bizon76/esr-meter/design/schematic-v1.1.pdf

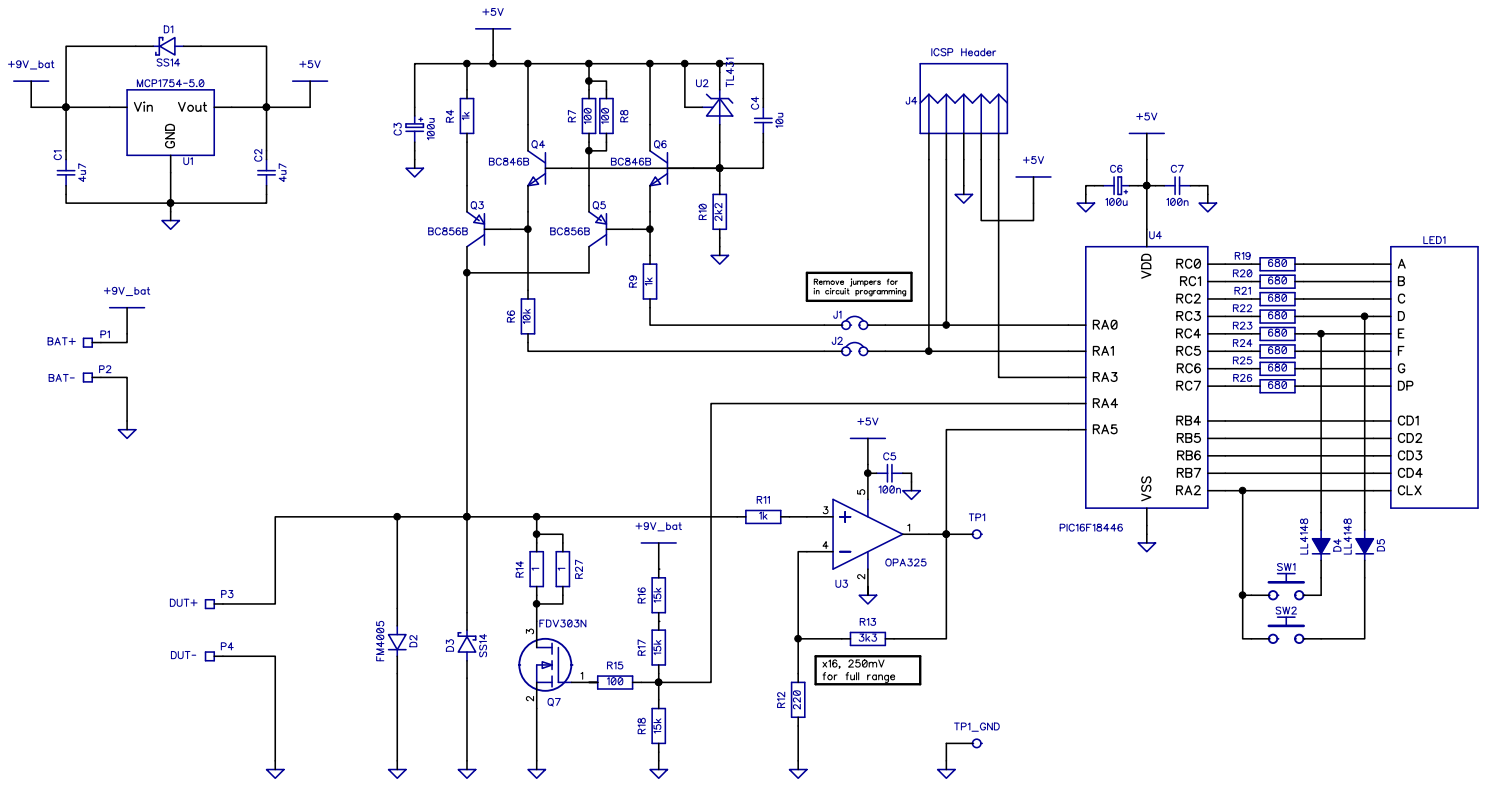
[picture p1: page 1]
