bizon76/esr-meter/design/schematic-v1.0.pdf

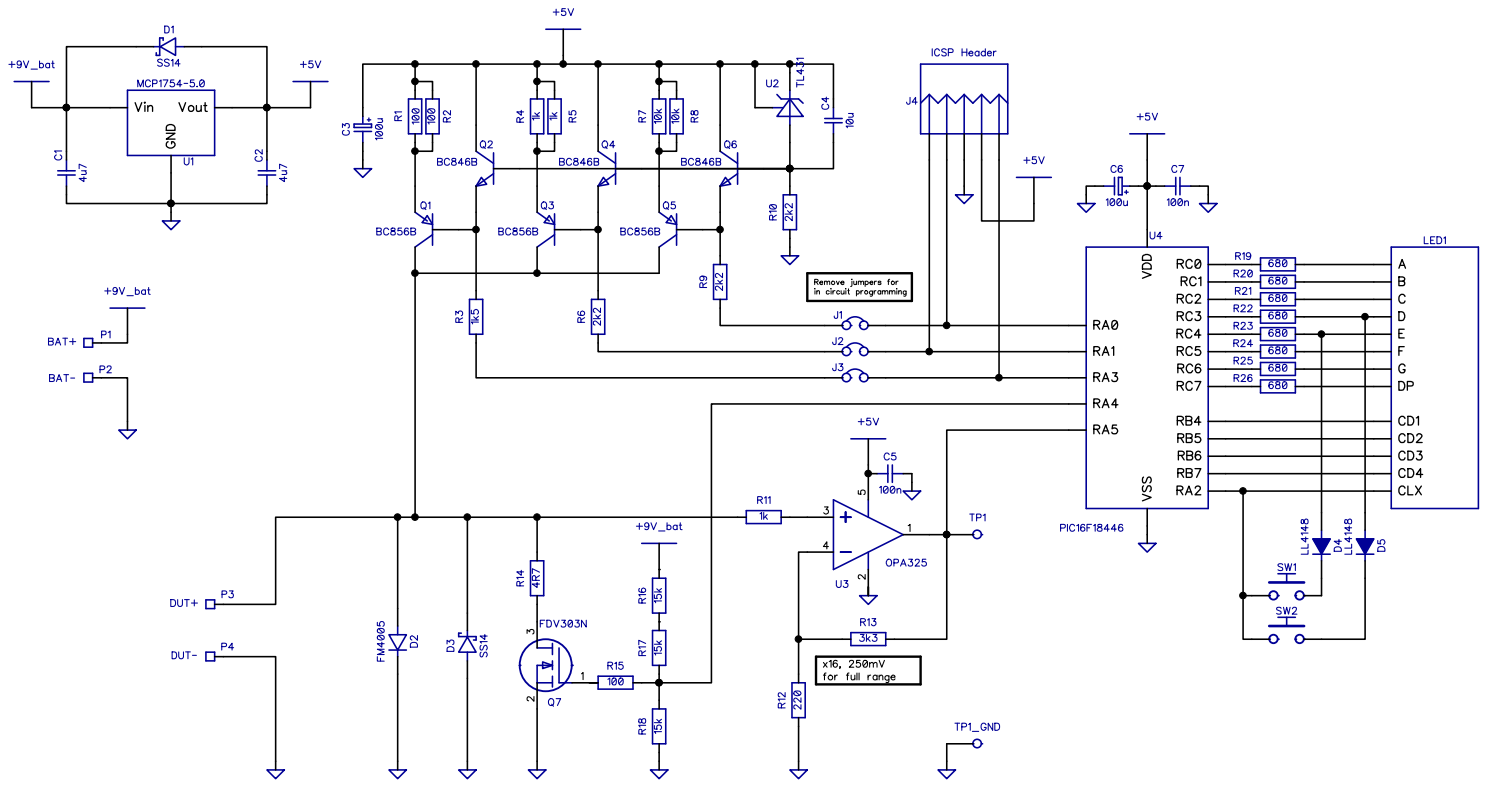
[picture p2: page 1]
