bizon76/esr-meter/(list of files, drawings)

Other design files:
design/ESR-meter-v1.0.dch
design/ESR-meter-v1.0.dip
design/ESR-meter-v1.1.dch
