bizon76/esr-meter/src/acquire.c

#include "mcc_generated_files/mcc.h"
#include "acquire.h"
#include "display.h"

#define waitForAdc()  __asm("MOVLB 0x2 \n BTFSC ADCON0, 0x0 \n GOTO $-1");
#define waitForAdcAndRestart()  __asm("MOVLB 0x2 \n BTFSC ADCON0, 0x0 \n GOTO $-1 \n BSF ADCON0, 0x0");
#define startTimer()     __asm("MOVLB 0x4 \n BSF T1CON, 0x0");
#define stopTimer()      __asm("MOVLB 0x4 \n BCF T1CON, 0x0");
#define waitForTimerOverFlow() __asm("MOVLB 0xE \n BTFSS PIR4, 0x0 \n GOTO $-1");

void initAdc(void)
{
    ADCC_DefineSetPoint(0);
    ADCC_SetUpperThreshold(0xffe);
            
    ADCON3bits.ADCALC = 1; // ERR = ADRES - ADSTPT = ADRES
}

// Takes [sampleCount] readings of ADC in quick succession and returns summed value
// Exits early with -1 if 0xfff is sampled
int32_t multiSampleAdc(uint16_t sampleCount)
{
    int32_t sum = 0;
    for(int i=0; i < sampleCount; i++)
    {
        ADCON0bits.GO = 1; //Start conversion
        while (ADCON0bits.GO) {} //Wait for conversion done

        uint16_t adcResult = readAdc();
        if(adcResult == 0xfff)
            return -1;

        sum += adcResult;
    }
    return sum;
}



void waitForDischarge(void)
{
    __delay_us(200);
    uint16_t lastVal = 0x7777;
    for(int k=0; k < 30; k++)
    {
        ADCON0bits.GO = 1; //Start conversion
        while (ADCON0bits.GO) {} //Wait for conversion done
        uint16_t val = readAdc();

        lastVal = val;

        // Zero reading means discharge done
        if(val == 0)
            break;

        // Allow some residual voltage after waiting about 1 ms
        // This is because large capacitors might not have time to completely discharge
        // Offset compensation should be able to deal with it
        if(k >= 8 && val <= 10) 
            break;

        __delay_us(90);
    }
    //displayHex(lastVal);
}



// Turns on current source and samples the analog signal twice in quick succession
// Then turns on discharge mosfet and waits until any analog signal reaches zero (or close to zero)
// The process is repeated "sampleCount" times
struct doubleSampleData fastDoubleSample(uint8_t currentSourcePinMask, uint16_t sampleCount)
{
    struct doubleSampleData res = {0};

    for(uint16_t i = 0; i < sampleCount; i++)
    {
        // Note 0x3e instructions between samples
        TMR1H = 0;
        TMR1L = 0;

        // Begin time critical section
        INTERRUPT_GlobalInterruptDisable();

        // Convert before starting and get the offset
        // For large caps there might not be enough time to discharge completely
        // Also it will sync against ADC clock
        __asm("MOVLB 0x2");
        __asm("BSF ADCON0, 0x0");
        __asm("BTFSC ADCON0, 0x0");
        __asm("GOTO $-1");
        uint16_t startOffset = readAdc();

        IO_RA4_LAT = 0; // Turn off discharge mosfet
        LATA &= ~currentSourcePinMask; // turn on current-source

        __delay_us(2);

    //    ADCON0bits.GO = 1; //Start conversion
        //T1CONbits.TMR1ON = 1; // Turn on timer
    //    while (ADCON0bits.GO) {} //Wait for conversion done
        __asm("MOVLB 0x2");
        __asm("BSF ADCON0, 0x0");
        __asm("MOVLB 0x4");
        __asm("BSF T1CON, 0x0");
        __asm("MOVLB 0x2");
        __asm("BTFSC ADCON0, 0x0");
        __asm("GOTO $-1");
        //ADCON0bits.GO = 1; //Start conversion
        //T1CONbits.TMR1ON = 0; // Turn off timer

        __asm("MOVLB 0x2");
        __asm("BSF ADCON0, 0x0");
        __asm("MOVLB 0x4");
        __asm("BCF T1CON, 0x0");

        // delay 12 instruction, should be enough for AD to have done sample
        // testing shows that just 2 instructions is enough after setting GO=1
        __asm("REPT 12 \n NOP \n ENDM");

        LATA |= currentSourcePinMask; // Turn off current source
        IO_RA4_LAT = 1; // Turn on discharge mosfet

        while (ADCON0bits.GO) {} //Wait for conversion done

        // End time critical section
        INTERRUPT_GlobalInterruptEnable();

        res.firstSum += readAdcPrev();
        uint16_t second = readAdc();

        if(second == 0xfff)
        {
            res.overRange = true;
            waitForDischarge();
            return res;
        }
        
        res.startOffsetSum += startOffset;
        res.secondSum += second;
        res.instructionsDelta = TMR1_ReadTimer();

        waitForDischarge();
    }
    return res;
}

// Samples many times in a row and sums the result. 
// Does calculations while ADC is running to speed up process. 
// Exits early with -1 if 0xfff is sampled

int24_t burstSampleSum(uint8_t burstLength)
{
    ADCON0bits.GO = 1; //Start conversion
    int24_t sum = 0;
    uint16_t sample;
    for(uint8_t x = burstLength-1; x > 0; x--)
    {
        waitForAdcAndRestart();
        sample = readAdc();
        if(ADSTATbits.UTHR) // Was greater than upper threshold
            return -1;
        sum += sample;
    }

    waitForAdc();
    sample = readAdc();
    if(ADSTATbits.UTHR) // Was greater than upper threshold
        return -1;
    sum += sample;
    return sum;
}

struct doubleSampleData sampleSlopeWithDelay(uint8_t burstLength, uint8_t currentSourcePinMask, uint16_t desiredDeltaInstructions)
{
    stopTimer();
    uint16_t timerVal = -desiredDeltaInstructions;
    TMR1H = (timerVal >> 8);
    TMR1L = timerVal;    
    
    struct doubleSampleData res = {0};
    INTERRUPT_GlobalInterruptDisable();
    IO_RA4_LAT = 0; // Turn off discharge mosfet
    LATA &= ~currentSourcePinMask; // turn on current-source
    __delay_us(2);
    startTimer();
    res.firstSum = burstSampleSum(burstLength);
    if(res.firstSum < 0)
        goto overrange;
    
    if(TMR1_ReadTimer() < 0xff00) // Note: Found that original value of 0xff80 is too high
    {
        // More than 255 clock cycles left, we can enable interrupts so display doesn't start flickering
        INTERRUPT_GlobalInterruptEnable();

        while(TMR1_ReadTimer() < 0xff00) {}
        // Run the last cycles with interrupts disabled for accurate timing
        INTERRUPT_GlobalInterruptDisable();
    }

    waitForTimerOverFlow();
    res.secondSum = burstSampleSum(burstLength);
    PIR4bits.TMR1IF = 0; // Clear timer overflow
    if(res.secondSum < 0)
        goto overrange;
    
    res.instructionsDelta = desiredDeltaInstructions;

    LATA |= currentSourcePinMask; // turn off current-source
    IO_RA4_LAT = 1; // Turn on discharge mosfet    
    INTERRUPT_GlobalInterruptEnable();
    waitForDischarge();
    return res;

overrange:
    LATA |= currentSourcePinMask; // turn off current-source
    IO_RA4_LAT = 1; // Turn on discharge mosfet    
    stopTimer();
    PIR4bits.TMR1IF = 0; // Clear timer overflow, just in case
    INTERRUPT_GlobalInterruptEnable();
    res.overRange = true;
    waitForDischarge();
    return res;
}


// Sample "burstLenght" times and put sum in firstSum
// Then sample "burstLenght" times and put sum in secondSum
// NOP instructions are for timing, each sample should be equally spaced with 59 instructions between
struct doubleSampleData sampleSlope(uint8_t burstLength, uint8_t currentSourcePinMask)
{
    stopTimer();
    TMR1H = 0;
    TMR1L = 0;
    burstLength --;
    uint16_t sample;
    struct doubleSampleData res = {0};
    int24_t firstSum = 0, secondSum = 0;
    INTERRUPT_GlobalInterruptDisable();
    IO_RA4_LAT = 0; // Turn off discharge mosfet
    LATA &= ~currentSourcePinMask; // turn on current-source
    __delay_us(2);
    ADCON0bits.GO = 1; //Start conversion
    
    startTimer();
    if(burstLength > 0)
    {
        uint8_t x = burstLength;
        _nop();
        while(true)
        {
            waitForAdcAndRestart();

            sample = readAdc();
            if(ADSTATbits.UTHR) // Was greater than upper threshold ?if(sample == 0x1fff)
                goto overrange;
            firstSum += sample;
            _nop();
            x--;
            if(x == 0)
                break;
        }
    }
    _nop();
    _nop();
    waitForAdcAndRestart();
    stopTimer();
    sample = readAdc();
    if(ADSTATbits.UTHR) // Was greater than upper threshold ?if(sample == 0x0fff)
        goto overrange;
    firstSum += sample;

    if(burstLength > 0)
    {
        uint8_t x = burstLength;
        _nop();
        while(true)
        {
            waitForAdcAndRestart();
            sample = readAdc();
            if(ADSTATbits.UTHR) // Was greater than upper threshold ?if(sample == 0x1fff)
                goto overrange;
            secondSum += sample;
            _nop();
            x--;
            if(x == 0)
                break;
        }
    }
    _nop();
    waitForAdc();
    sample = readAdc();
    if(ADSTATbits.UTHR) // Was greater than upper threshold ?if(sample == 0x0fff)
        goto overrange;
    secondSum += sample;

    LATA |= currentSourcePinMask; // turn off current-source
    IO_RA4_LAT = 1; // Turn on discharge mosfet    
    INTERRUPT_GlobalInterruptEnable();
    res.overRange = false;
    res.firstSum = firstSum;
    res.secondSum = secondSum;
    res.instructionsDelta = TMR1_ReadTimer() - 2;
    waitForDischarge();
    return res;
overrange:
    LATA |= currentSourcePinMask; // turn off current-source
    IO_RA4_LAT = 1; // Turn on discharge mosfet    
    stopTimer();
    INTERRUPT_GlobalInterruptEnable();
    res.overRange = true;
    waitForDischarge();
    return res;
}
