bizon76/esr-meter/src/capacitance.h

/* 
 * File:   capacitance.h
 * Author: Erik
 *
 * Created on March 27, 2021, 11:31 PM
 */

#ifndef CAPACITANCE_H
#define	CAPACITANCE_H

#ifdef	__cplusplus
extern "C" {
#endif

bool findRangeAndMeasureC(void);
void measureCapacitance(void);


#ifdef	__cplusplus
}
#endif

#endif	/* CAPACITANCE_H */
