bizon76/esr-meter/src/acquire.h

/* 
 * File:   adc.h
 * Author: Erik
 *
 * Created on March 23, 2021, 10:05 PM
 */

#ifndef ADC_H
#define	ADC_H

#ifdef	__cplusplus
extern "C" {
#endif

#define readAdc() ((uint16_t)((ADRESH << 8) + ADRESL));
#define readAdcPrev() ((uint16_t)((ADPREVH << 8) + ADPREVL));
    
struct doubleSampleData
{
    int32_t startOffsetSum;
    int32_t firstSum;
    int32_t secondSum;
    uint16_t instructionsDelta;
    bool overRange;
};

void initAdc(void);
int32_t multiSampleAdc(uint16_t sampleCount);

struct doubleSampleData fastDoubleSample(uint8_t currentSourcePinMask, uint16_t sampleCount);
int24_t burstSampleSum(uint8_t burstLength);
struct doubleSampleData sampleSlopeWithDelay(uint8_t burstLength, uint8_t currentSourcePinMask, uint16_t desiredDeltaInstructions);
struct doubleSampleData sampleSlope(uint8_t burstLength, uint8_t currentSourcePinMask);

#ifdef	__cplusplus
}
#endif

#endif	/* ADC_H */
