bizon76/esr-meter/src/dual.h

/* 
 * File:   dual.h
 * Author: Erik
 *
 * Created on April 11, 2021, 6:50 PM
 */

#ifndef DUAL_H
#define	DUAL_H

#ifdef	__cplusplus
extern "C" {
#endif

void dualMeasureCapAndESR(int32_t lowZeroOffset, int32_t highZeroOffset);

#ifdef	__cplusplus
}
#endif

#endif	/* DUAL_H */
