bizon76/esr-meter/(commit log)

2021-02-28 Various settings tweaks
    Moved display code to separate file
    Added resistance measurement POC code
2021-04-04 WIP - Timed sampleSlope method
2021-04-05 WIP. Autoranging for capacitance measurement implemented
2021-04-06 WIP. Capacitance mode now working.
2021-04-09 diptrace files and schematic
    [ESR-meter.dch, ESR-meter.dip]
2021-04-09 updated schematic to current version
    [ESR-meter-v1.0.dch, ESR-meter-v1.0.dip, ESR-meter-v1.1.dch]
2021-04-11 dual mode bug fix
    [capacitance.c, capacitance.h, dual.c, esr.c, esr.h]
